luizspinola/E-SCR/README.md

Repositório dos Arquivos criados e desenvolvidos no projeto da disciplina de Experimental de Sistemas de Controle Realimentado da Faculdade de Engenharia Elétrica da Universidade Federal de Uberlândia.

Este projeto foi desenvolvido pelos alunos: Luiz Felipe Spinola Silva (12121EBI001), Beatriz Martins Gomes Silva (12121EBI003) e Júlia Miranda Brito (12121EBI020).

Todo o desenvolvimento do projeto está explicado no PDF Projeto_Final___ESCR.pdf
