luizspinola/E-SCR/ENSAIOS FINAIS/ENSAIO2PWM.jpg

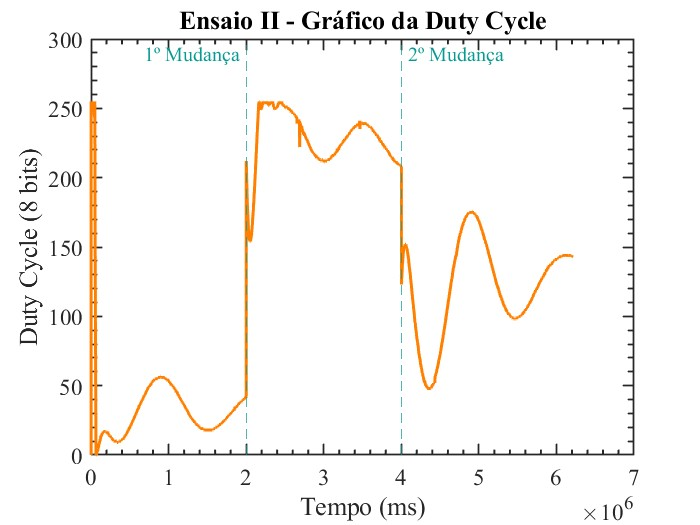
ENSAIOS FINAIS/ENSAIO2PWM.jpg
