luizspinola/E-SCR/ENSAIOS FINAIS/ENSAIO2TEMP.jpg

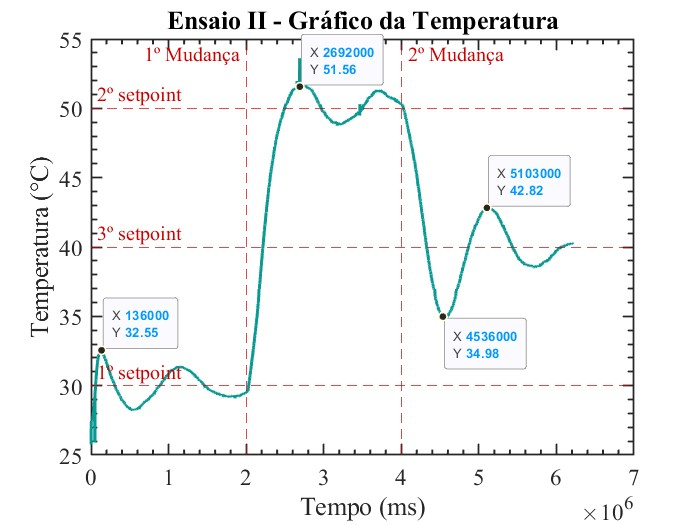
ENSAIOS FINAIS/ENSAIO2TEMP.jpg
