luizspinola/E-SCR/ENSAIOS FINAIS/ENSAIO3FLUX.jpg

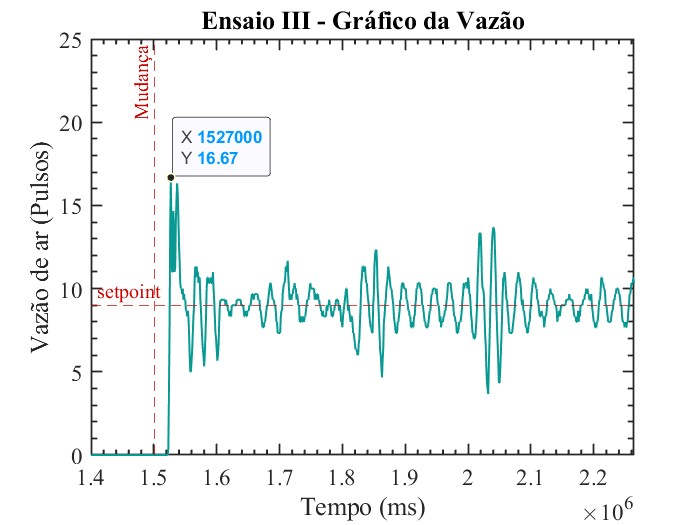
ENSAIOS FINAIS/ENSAIO3FLUX.jpg
