luizspinola/E-SCR/ENSAIOS FINAIS/ENSAIO3PWMTEMP.jpg

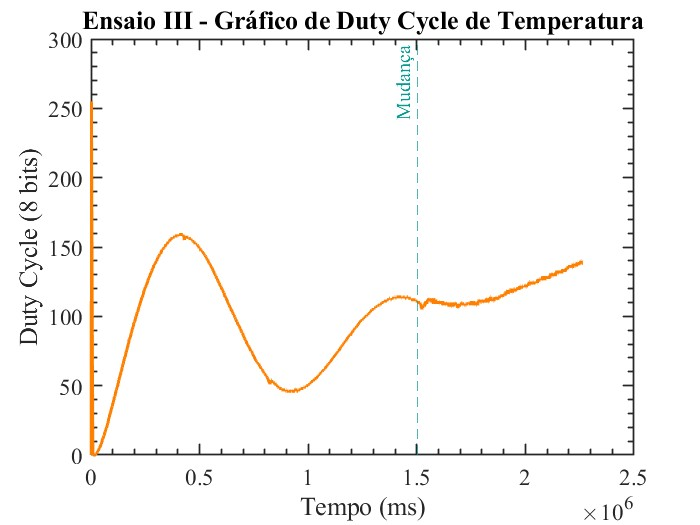
ENSAIOS FINAIS/ENSAIO3PWMTEMP.jpg
